shiny-mira/zc95/kicad/MainBoard/MainBoard.kicad_pcb

## KiCad design kicad/MainBoard/MainBoard.kicad_pcb (2024-11-02)

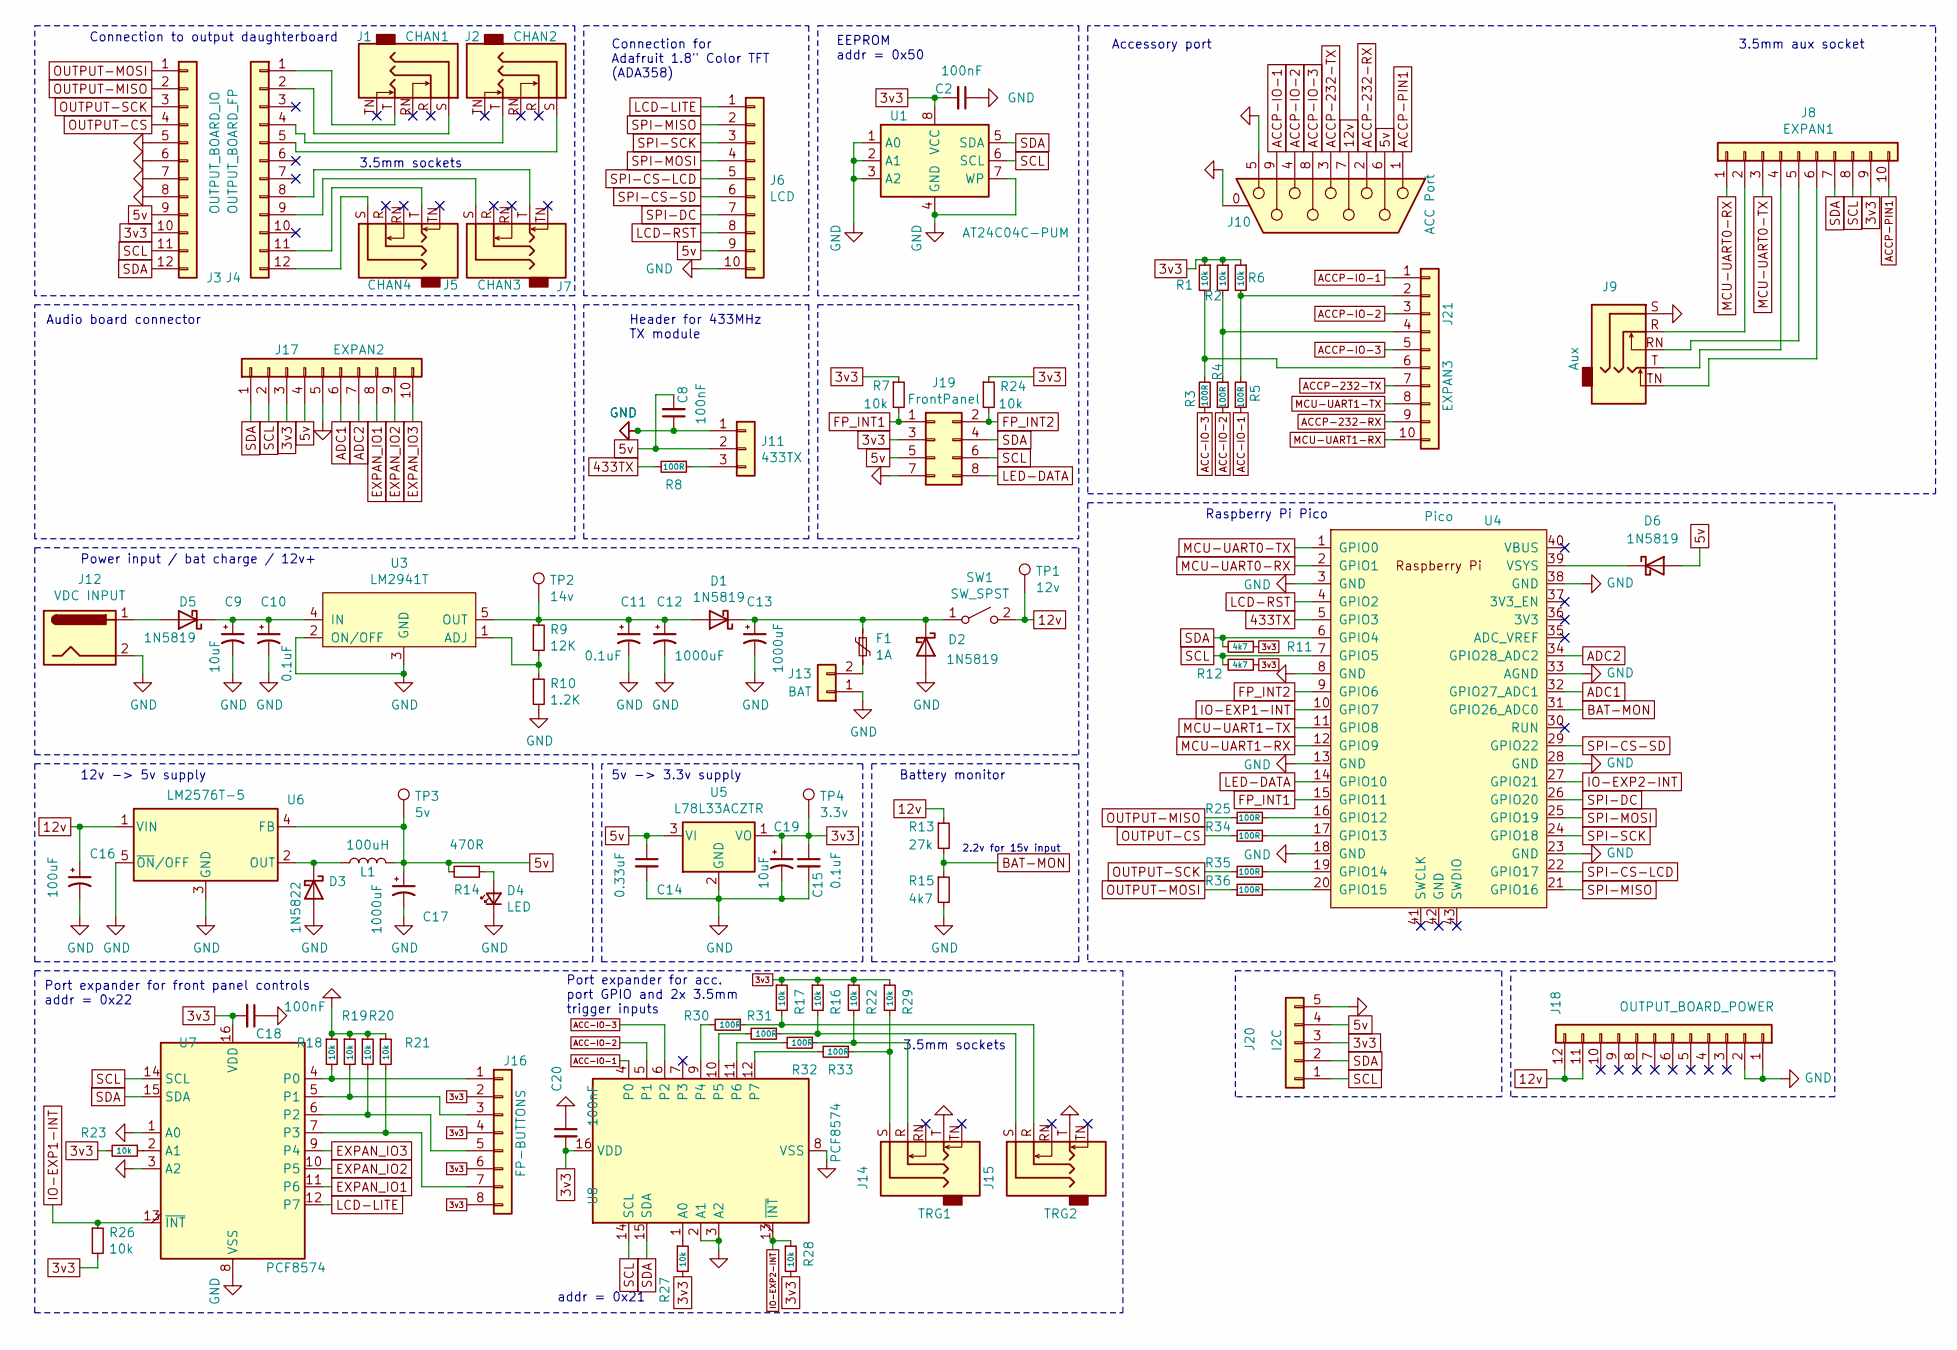
[picture p1: schematic MainBoard.kicad_sch, ZC95 main board]

Parts:
C2, C8, C18, C20: 100nF; C_Disc_D3.0mm_W2.0mm_P2.50mm
C9, C19: 10uF; CP_Radial_D5.0mm_P2.00mm
C10, C11, C15: 0.1uF; C_Disc_D3.0mm_W2.0mm_P2.50mm
C12, C13, C17: 1000uF; CP_Radial_D10.0mm_P5.00mm
C14: 0.33uF; C_Disc_D10.5mm_W5.0mm_P5.00mm
C16: 100uF; CP_Radial_D6.3mm_P2.50mm
D1, D2, D5, D6: 1N5819; D_DO-41_SOD81_P10.16mm_Horizontal
D3: 1N5822; D_DO-201AD_P15.24mm_Horizontal
D4: LED; PinSocket_1x02_P2.54mm_Vertical
F1: 1A; Fuse_Littelfuse_395Series
J1: CHAN1; STX31005N
J2: CHAN2; STX31005N
J3: OUTPUT_BOARD_IO; PinSocket_1x12_P2.54mm_Vertical
J4: OUTPUT_BOARD_FP; PinSocket_1x12_P2.54mm_Vertical
J5: CHAN4; STX31005N
J6: LCD; PinSocket_1x10_P2.54mm_Vertical
J7: CHAN3; STX31005N
J8: EXPAN1; PinSocket_1x10_P2.54mm_Vertical
J9: Aux; STX31005N
J10: ACC Port; DSUB-9_Female_Horizontal_P2.77x2.84mm_EdgePinOffset7.70mm_H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
J11: 433TX; PinSocket_1x03_P2.54mm_Vertical
J12: VDC INPUT; DC-005-2.5A-2.0
J13: BAT; Molex_Mini-Fit_Jr_5566-02A_2x01_P4.20mm_Vertical
J14: TRG1; STX31005N
J15: TRG2; STX31005N
J16: FP-BUTTONS; PinSocket_1x08_P2.54mm_Vertical
J17: EXPAN2; PinSocket_1x10_P2.54mm_Vertical
J18: OUTPUT_BOARD_POWER; PinSocket_1x12_P2.54mm_Vertical
J19: FrontPanel; IDC-Header_2x04_P2.54mm_Vertical
J20: I2C; PinSocket_1x05_P2.54mm_Vertical
J21: EXPAN3; PinSocket_1x10_P2.54mm_Vertical
L1: 100uH; L_Radial_D9.5mm_P5.00mm_Fastron_07HVP
R1, R2, R6, R7, R16, R17, R18, R19, R20, R21, R22, R23, R24, R26, R27, R28, R29: 10k; R_Axial_DIN0207_L6.3mm_D2.5mm_P10.16mm_Horizontal
R3, R4, R5, R8, R25, R30, R31, R32, R33, R34, R35, R36: 100R; R_Axial_DIN0207_L6.3mm_D2.5mm_P10.16mm_Horizontal
R9: 12K; R_Axial_DIN0207_L6.3mm_D2.5mm_P10.16mm_Horizontal
R10: 1.2K; R_Axial_DIN0207_L6.3mm_D2.5mm_P10.16mm_Horizontal
R11, R12, R15: 4k7; R_Axial_DIN0207_L6.3mm_D2.5mm_P10.16mm_Horizontal
R13: 27k; R_Axial_DIN0207_L6.3mm_D2.5mm_P10.16mm_Horizontal
R14: 470R; R_Axial_DIN0207_L6.3mm_D2.5mm_P10.16mm_Horizontal
SW1: SW_SPST; SS-12D06L5
TP1: 12v; TestPoint_Pad_1.0x1.0mm
TP2: 14v; TestPoint_Pad_1.0x1.0mm
TP3: 5v; TestPoint_Pad_1.0x1.0mm
TP4: 3.3v; TestPoint_Pad_1.0x1.0mm
U1: AT24C04C-PUM; DIP-8_W7.62mm_Socket
U3: LM2941T; TO-220-5_Horizontal_TabDown
U4: Pico; RPi_Pico_SMD_TH
U5: L78L33ACZTR; TO-92_Inline_Wide
U6: LM2576T-5; TO-220-5_Vertical
U7, U8: PCF8574; DIP-16_W7.62mm_Socket

Connections:
3v3: C2.2, C15.1, C18.2, C19.1, C20.2, J3.10, J8.9, J16.2, J16.4, J16.6, J16.8, J17.3, J19.3, J20.3, R1.1, R2.1, R6.1, R7.1, R11.1, R12.1, R16.1, R17.1, R22.1, R23.2, R24.1, R26.2, R27.2, R28.2, R29.1, TP4.1, U1.8 (VCC), U5.1 (VO), U7.16 (VDD), U8.16 (VDD)
5v: C8.2, C14.1, C17.1, D6.2 (A), J3.9, J6.9, J10.6, J11.2, J17.4, J19.5, J20.4, L1.2, R14.2, TP3.1, U5.3 (VI), U6.4 (FB)
12v: C16.1, J10.7, J18.11, J18.12, R13.1, SW1.2 (B), TP1.1, U6.1 (VIN)
433TX: R8.2, U4.5 (GPIO3)
ACC-IO-1: R5.1, U8.4 (P0)
ACC-IO-2: R4.1, U8.5 (P1)
ACC-IO-3: R3.1, U8.6 (P2)
ACCP-232-RX: J10.2, J21.9
ACCP-232-TX: J10.3, J21.7
ACCP-IO-1: J10.9, J21.1
ACCP-IO-2: J10.4, J21.3
ACCP-IO-3: J10.8, J21.5
ACCP-PIN1: J8.10, J10.1
ADC1: J17.6, U4.32 (GPIO27_ADC1)
ADC2: J17.7, U4.34 (GPIO28_ADC2)
BAT-MON: R13.2, R15.1, U4.31 (GPIO26_ADC0)
EXPAN_IO1: J17.8, U7.11 (P6)
EXPAN_IO2: J17.9, U7.10 (P5)
EXPAN_IO3: J17.10, U7.9 (P4)
FP_INT1: J19.1, R7.2, U4.15 (GPIO11)
FP_INT2: J19.2, R24.2, U4.9 (GPIO6)
GND: C2.1, C8.1, C9.2, C10.2, C11.2, C12.2, C13.2, C14.2, C15.2, C16.2, C17.2, C18.1, C19.2, C20.1, D2.2 (A), D3.2 (A), D4.1 (K), J3.5, J3.6, J3.7, J3.8, J6.10, J9.S, J10.0 (PAD), J10.5, J11.1, J12.2, J13.1, J14.T, J15.T, J17.5, J18.1, J18.2, J19.7, J20.5, R10.2, R15.2, R18.1, R19.1, R20.1, R21.1, U1.1 (A0), U1.2 (A1), U1.3 (A2), U1.4 (GND), U1.7 (WP), U3.2 (ON/OFF), U3.3 (GND), U4.3 (GND), U4.8 (GND), U4.13 (GND), U4.18 (GND), U4.23 (GND), U4.28 (GND), U4.33 (AGND), U4.38 (GND), U5.2 (GND), U6.3 (GND), U6.5 (~ON/OFF), U7.1 (A0), U7.3 (A2), U7.8 (VSS), U8.2 (A1), U8.3 (A2), U8.8 (VSS)
IO-EXP1-INT: R26.1, U4.10 (GPIO7), U7.13 (~INT)
IO-EXP2-INT: R28.1, U4.27 (GPIO21), U8.13 (~INT)
LCD-LITE: J6.1, U7.12 (P7)
LCD-RST: J6.8, U4.4 (GPIO2)
LED-DATA: J19.8, U4.14 (GPIO10)
MCU-UART0-RX: J8.1, U4.2 (GPIO1)
MCU-UART0-TX: J8.3, U4.1 (GPIO0)
MCU-UART1-RX: J21.10, U4.12 (GPIO9)
MCU-UART1-TX: J21.8, U4.11 (GPIO8)
unnamed: C11.1, C12.1, D1.2 (A), R9.1, TP2.1, U3.5 (OUT)
unnamed: C13.1, D1.1 (K), D2.1 (K), F1.1, SW1.1 (A)
unnamed: D3.1 (K), L1.1, U6.2 (OUT)
unnamed: D4.2 (A), R14.1
unnamed: D5.2 (A), J12.1
unnamed: C9.1, C10.1, D5.1 (K), U3.4 (IN)
unnamed: D6.1 (K), U4.39 (VSYS)
unnamed: J1.T, J4.1
unnamed: J1.S, J4.2
unnamed: J2.T, J4.4
unnamed: J2.S, J4.5
unnamed: J4.8, J7.T
unnamed: J4.9, J7.S
unnamed: J4.11, J5.T
unnamed: J4.12, J5.S
unnamed: J8.2, J9.R
unnamed: J8.4, J9.T
unnamed: J8.5, J9.RN
unnamed: J8.6, J9.TN
unnamed: J11.3, R8.1
unnamed: F1.2, J13.2
unnamed: J14.R, R22.2, R32.1
unnamed: J14.S, R29.2, R33.1
unnamed: J15.R, R17.2, R30.1
unnamed: J15.S, R16.2, R31.1
unnamed: J16.1, R18.2, U7.4 (P0)
unnamed: J16.3, R19.2, U7.5 (P1)
unnamed: J16.5, R20.2, U7.6 (P2)
unnamed: J16.7, R21.2, U7.7 (P3)
unnamed: J21.2, R5.2, R6.2
unnamed: J21.4, R2.2, R4.2
unnamed: J21.6, R1.2, R3.2
unnamed: R9.2, R10.1, U3.1 (ADJ)
unnamed: R25.2, U4.16 (GPIO12)
unnamed: R34.2, U4.17 (GPIO13)
unnamed: R35.2, U4.19 (GPIO14)
unnamed: R36.2, U4.20 (GPIO15)
unnamed: R23.1, U7.2 (A1)
unnamed: R27.1, U8.1 (A0)
unnamed: R30.2, U8.9 (P4)
unnamed: R31.2, U8.10 (P5)
unnamed: R32.2, U8.11 (P6)
unnamed: R33.2, U8.12 (P7)
OUTPUT-CS: J3.4, R34.1
OUTPUT-MISO: J3.2, R25.1
OUTPUT-MOSI: J3.1, R36.1
OUTPUT-SCK: J3.3, R35.1
SCL: J3.11, J8.8, J17.2, J19.6, J20.1, R12.2, U1.6 (SCL), U4.7 (GPIO5), U7.14 (SCL), U8.14 (SCL)
SDA: J3.12, J8.7, J17.1, J19.4, J20.2, R11.2, U1.5 (SDA), U4.6 (GPIO4), U7.15 (SDA), U8.15 (SDA)
SPI-CS-LCD: J6.5, U4.22 (GPIO17)
SPI-CS-SD: J6.6, U4.29 (GPIO22)
SPI-DC: J6.7, U4.26 (GPIO20)
SPI-MISO: J6.2, U4.21 (GPIO16)
SPI-MOSI: J6.4, U4.25 (GPIO19)
SPI-SCK: J6.3, U4.24 (GPIO18)

Notes on the sheet:
3.5mm sockets
Raspberry Pi Pico
Connection to output daughterboard
2.2v for 15v input
addr = 0x21
EEPROM addr = 0x50
3.5mm aux socket
Connection for Adafruit 1.8" Color TFT (ADA358)
Audio board connector
Accessory port
Port expander for acc. port GPIO and 2x 3.5mm trigger inputs
Port expander for front panel controls addr = 0x22
Header for 433MHz TX module
12v -> 5v supply
Battery monitor
Power input / bat charge / 12v+
5v -> 3.3v supply

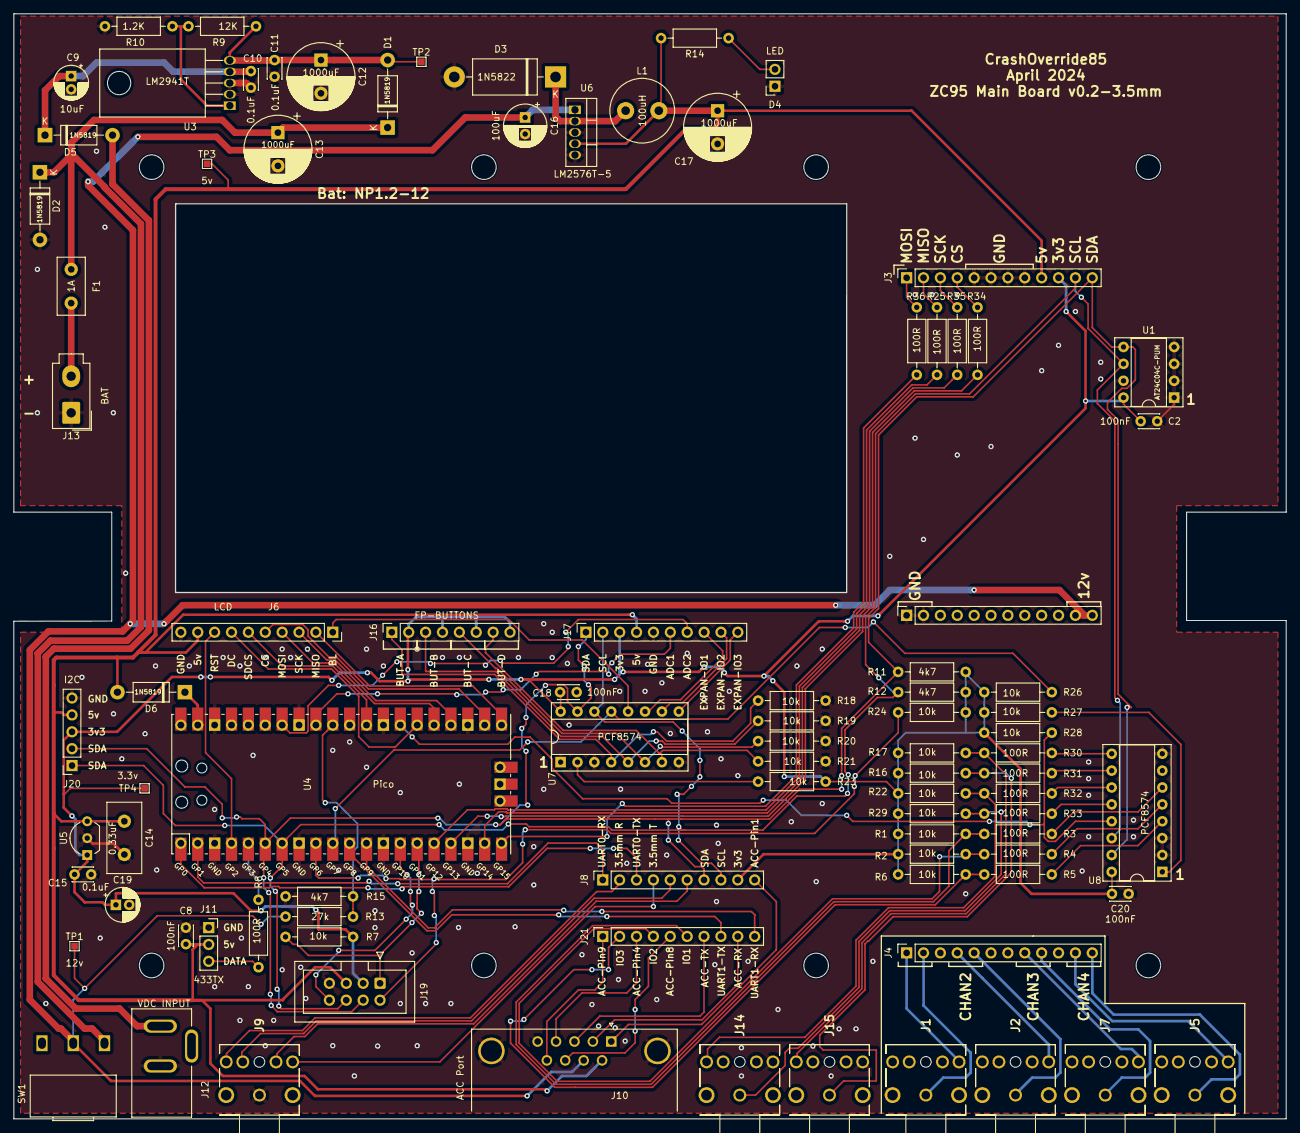
[picture p2: board MainBoard.kicad_pcb from above]

Board: 2 copper layers, 191.5 x 166.3 mm, 91 parts (0 on the bottom side), 86 nets.
