shiny-mira/zc95/kicad/FrontPanelControls/PanelControls.kicad_pcb

## KiCad design kicad/FrontPanelControls/PanelControls.kicad_pcb (2024-04-08)

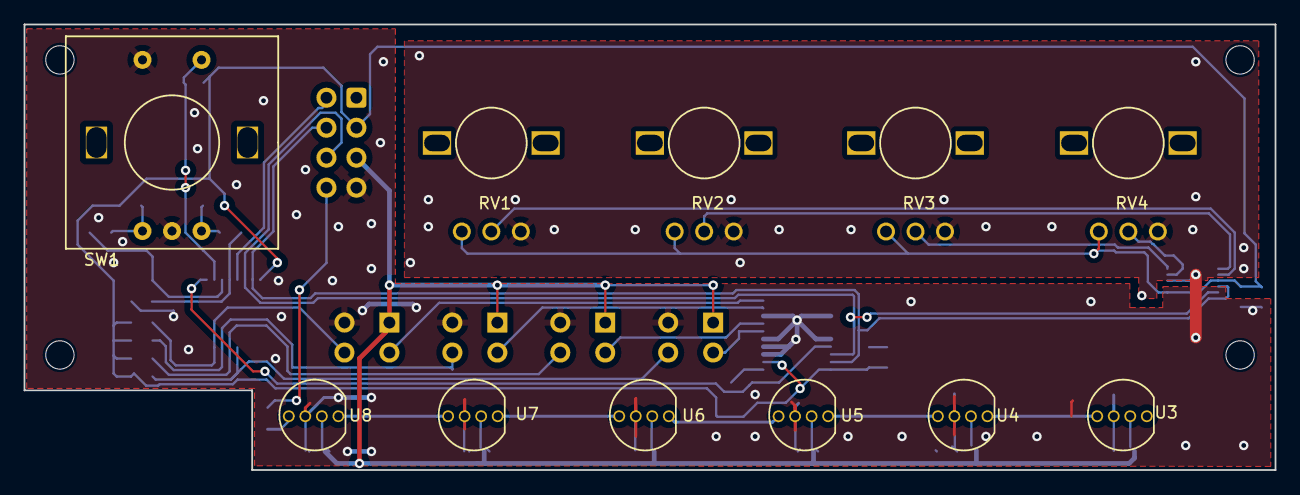
[picture p3: board PanelControls.kicad_pcb from above]

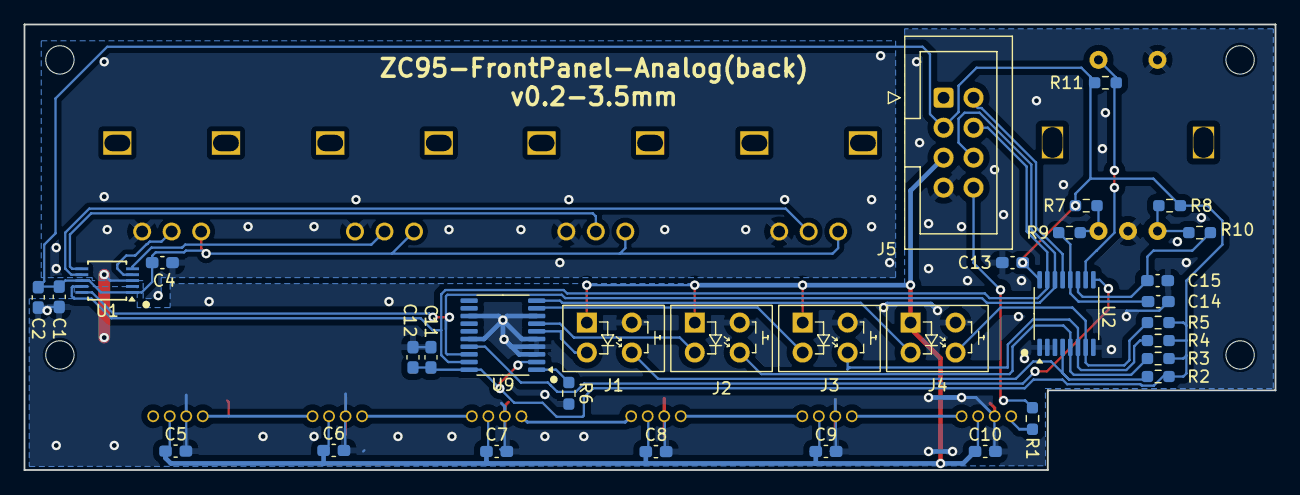
[picture p4: board PanelControls.kicad_pcb from below]

Board: 2 copper layers, 106.0 x 37.8 mm, 44 parts (33 on the bottom side), 32 nets.

Parts:
C1, C4, C5, C6, C7, C8, C9, C10, C11, C13, C14, C15: 100nF; C_0603_1608Metric_Pad1.08x0.95mm_HandSolder
C2, C12: 10uF; C_0603_1608Metric_Pad1.08x0.95mm_HandSolder
J1: BUTTON_A; ButtonConnector
J2: BUTTON_B; ButtonConnector
J3: BUTTON_C; ButtonConnector
J4: BUTTON_D; ButtonConnector
J5: Conn_02x04_Odd_Even; IDC-Header_2x04_P2.54mm_Vertical
R1: 100R; R_0603_1608Metric_Pad0.98x0.95mm_HandSolder
R2, R3, R4, R5, R7, R8, R9, R10, R11: 10K; R_0603_1608Metric_Pad0.98x0.95mm_HandSolder
R6: 1K; R_0603_1608Metric_Pad0.98x0.95mm_HandSolder
RV1, RV2, RV3, RV4: R_POT; ALPSALPINE RK09L1140A2U
SW1: ADJ; BOURNS PEC11L-4125F-S0020
U1: ADS1115IDGS; TSSOP-10_3x3mm_P0.5mm
U2: TCA9534; TSSOP-16_4.4x5mm_P0.65mm
U3, U4, U5, U6, U7, U8: WS2812D; WS2812D-F5
U9: TLC59108IPWR; TSSOP-20_4.4x6.5mm_P0.65mm

Connections:
+3v3: C1.1, C2.1, C4.1, C11.1, C12.1, C13.2, J5.3, R2.1, R3.1, R4.1, R5.1, R7.1, R8.1, R11.1, RV1.1, RV2.1, RV3.1, RV4.1, U1.1 (ADDR), U1.8 (VDD), U2.16 (VDD), U9.2 (A0), U9.20 (VCC)
+5v: C5.1, C6.1, C7.1, C8.1, C9.1, C10.1, J1.1, J2.1, J3.1, J4.1, J5.5, U3.2 (VCC), U4.2 (VCC), U5.2 (VCC), U6.2 (VCC), U7.2 (VCC), U8.2 (VCC)
GND: C1.2, C2.2, C4.2, C5.2, C6.2, C7.2, C8.2, C9.2, C10.2, C11.2, C12.2, C13.1, C14.2, C15.2, J1.2, J2.2, J3.2, J4.2, J5.7, R6.2, RV1.3, RV2.3, RV3.3, RV4.3, SW1.C, SW1.S1, U1.3 (GND), U2.1 (A0), U2.2 (A1), U2.3 (A2), U2.8 (GND), U3.3 (GND), U4.3 (GND), U5.3 (GND), U6.3 (GND), U7.3 (GND), U8.3 (GND), U9.3 (A1), U9.4 (A2), U9.5 (A3), U9.8 (GND), U9.13 (GND), U9.16 (GND)
INT2: J5.2, U2.13 (~INT)
LED_DATA: J5.8, R1.1
unnamed: J1.3, U9.6 (~OUT0)
unnamed: J1.4, R2.2, U2.4 (P0)
unnamed: J2.3, U9.7 (~OUT1)
unnamed: J2.4, R3.2, U2.5 (P1)
unnamed: J3.3, U9.9 (~OUT2)
unnamed: J3.4, R4.2, U2.6 (P2)
unnamed: J4.3, U9.10 (~OUT3)
unnamed: J4.4, R5.2, U2.7 (P3)
unnamed: R1.2, U8.4 (DIN)
unnamed: R6.1, U9.1 (REXT)
unnamed: R7.2, R9.2, SW1.B
unnamed: R8.2, R10.1, SW1.A
unnamed: RV1.2, U1.7 (AIN3)
unnamed: RV2.2, U1.6 (AIN2)
unnamed: RV3.2, U1.5 (AIN1)
unnamed: RV4.2, U1.4 (AIN0)
unnamed: U3.4 (DIN), U4.1 (DOUT)
unnamed: U4.4 (DIN), U5.1 (DOUT)
unnamed: U5.4 (DIN), U6.1 (DOUT)
unnamed: U6.4 (DIN), U7.1 (DOUT)
unnamed: U7.4 (DIN), U8.1 (DOUT)
RESET: U2.9 (P4), U9.17 (~RESET)
ROT5-A: C15.1, R10.2, U2.11 (P6)
ROT5-B: C14.1, R9.1, U2.12 (P7)
ROT5-BUT: R11.2, SW1.S2, U2.10 (P5)
SCL: J5.6, U1.10 (SCL), U2.14 (SCL), U9.18 (SCL)
SDA: J5.4, U1.9 (SDA), U2.15 (SDA), U9.19 (SDA)
