shiny-mira/zc95/(commit log)

2024-03-27 Convert schematic to KiCad 8
    [MainBoard.kicad_sch, MainBoard.sch]
2024-03-27 Convert board to Kicad 8
    [MainBoard.kicad_pcb]
2024-03-27 Switch Mainboard Q1, D1, D2, D5 with 1N5819
    [MainBoard.kicad_pcb, MainBoard.kicad_sch]
2024-03-27 Fix outline
    [MainBoard.kicad_pcb]
2024-03-27 Move things a bit for potential additional header
    [MainBoard.kicad_pcb]
2024-03-27 Add header for RS232 configuration
    [MainBoard.kicad_pcb, MainBoard.kicad_sch]
2024-03-27 Before 3.5mm footprint switch
    [MainBoard.kicad_pcb, MainBoard.kicad_sch]
2024-03-28 Switch everything to 3.5mm plugs
    [MainBoard.kicad_pcb, MainBoard.kicad_sch]
2024-04-05 One more 3d model
    [MainBoard.kicad_pcb]
2024-04-05 No more 12v rs232 - move to UART
    [MainBoard.kicad_pcb, MainBoard.kicad_sch]
2024-04-07 Small changes to expander
    [MainBoard.kicad_pcb, MainBoard.kicad_sch]
2024-04-08 More tiny mainboard updates
    [MainBoard.kicad_pcb]
2024-04-08 fix edge cut violations on front panel
    [FrontPannel-ADA358.kicad_pcb]
2024-04-08 Rename FrontPanel
    [FrontPanel-ADA358.kicad_pcb]
2024-04-08 FrontPanel MainBoard alignment
    [FrontPanel-ADA358.kicad_pcb, MainBoard.kicad_pcb]
2024-04-08 3d models for Panel Controls
    [PanelControls.kicad_pcb]
2024-04-08 Move to fit new 3.5mm holes
    [FrontPanel-ADA358.kicad_pcb, MainBoard.kicad_pcb, PanelControls.kicad_pcb]
2024-04-22 Fix missing connection on mainboard
    [MainBoard.kicad_pcb]
2024-04-22 Add optional design for a Back panel
    [BackPanel.kicad_pcb]
2024-11-02 Fix connections of output jacks
    [MainBoard.kicad_pcb, MainBoard.kicad_sch]
